hackthenorth/badge-hardware/README.md

# badge-hardware
Physical Hardware Designs for the 2026 Hacker Badge Project

IBOM Link: https://hackathon.github.io/badge-hardware/badge-ibom.html
