hackthenorth/badge-hardware/badge.kicad_pcb

## KiCad design badge.kicad_pcb (2026-10-14)

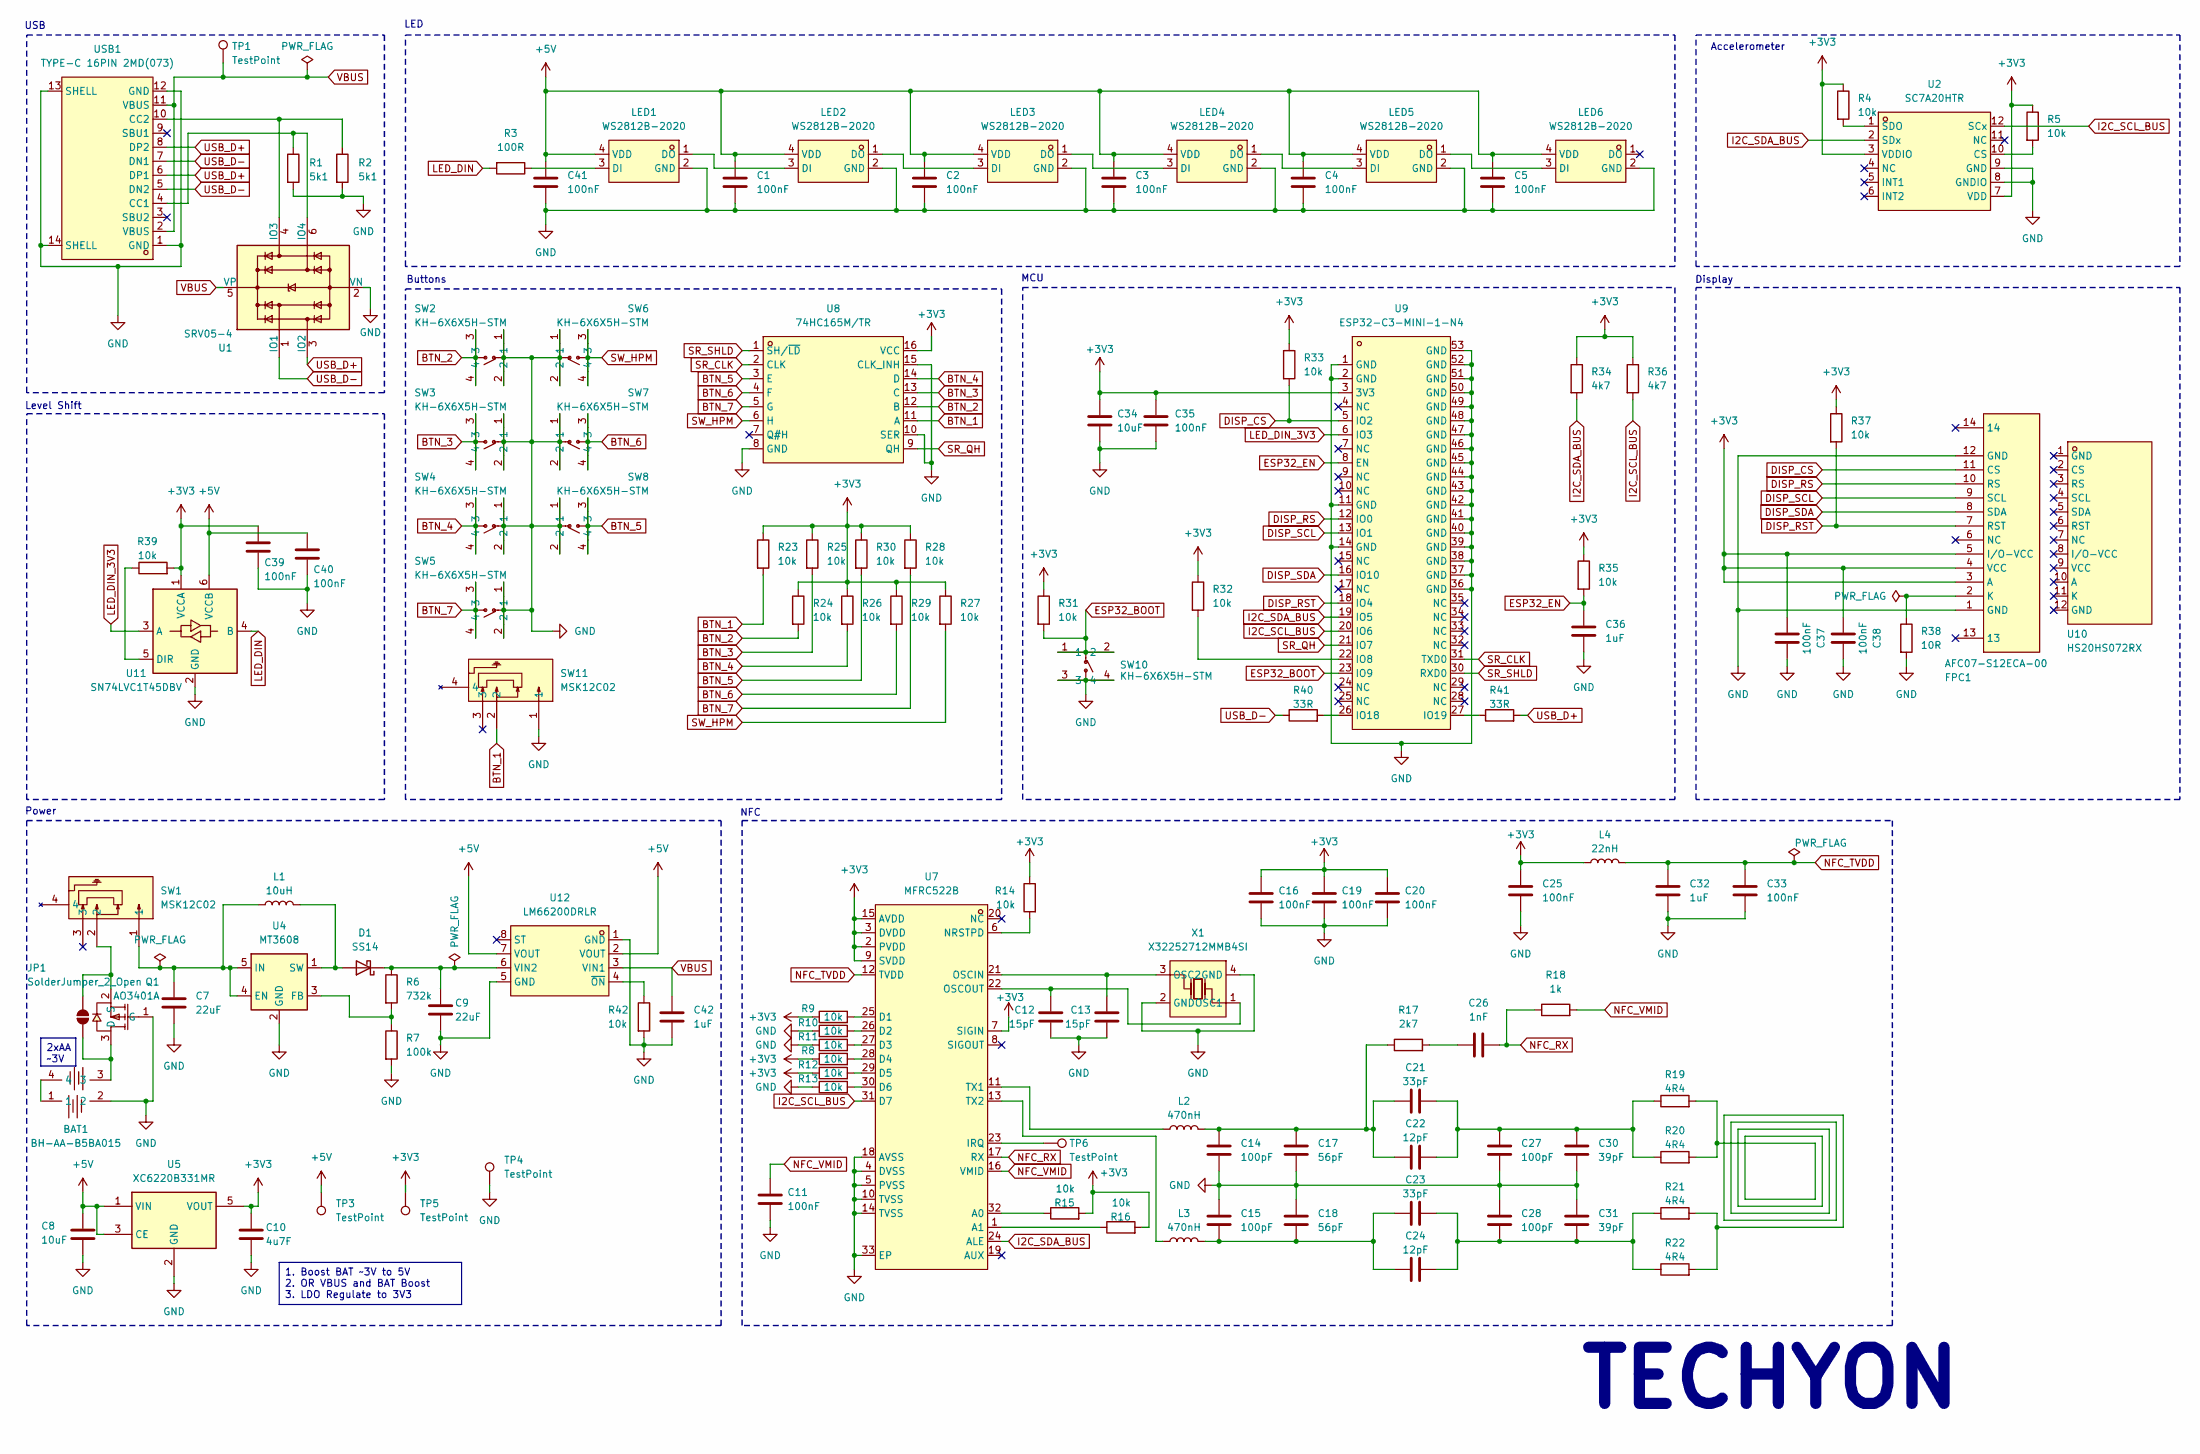
[picture p1: schematic badge.kicad_sch, Hacker Badge]

Parts:
BAT1: BH-AA-B5BA015; BAT-SMD_BH-AA-B5BA015; LCSC Part C5290182
C1, C2, C3, C4, C5, C11, C16, C19, C20, C25, C33, C41: 100nF; C_0805_2012Metric
C7, C9: 22uF; C_0805_2012Metric; LCSC Part C45783
C8, C34: 10uF; C_0805_2012Metric; LCSC Part C440198
C10: 4u7F; C_0805_2012Metric; LCSC Part C1779
C12, C13: 15pF; C_0805_2012Metric
C14, C15, C27, C28: 100pF; C_0805_2012Metric
C17, C18: 56pF; C_0805_2012Metric
C21, C23: 33pF; C_0805_2012Metric
C22, C24: 12pF; C_0805_2012Metric
C26: 1nF; C_0805_2012Metric
C30, C31: 39pF; C_0805_2012Metric
C32, C42: 1uF; C_0805_2012Metric
C35, C37, C38, C39, C40: 100nF; C_0805_2012Metric; LCSC Part C49678
C36: 1uF; C_0805_2012Metric; LCSC Part C28323
D1: SS14; D_SMA; LCSC Part C2480
FPC1: AFC07-S12ECA-00; FPC-SMD_12P-P0.50_AFC07-S12ECA-00; LCSC Part C262585
JP1: SolderJumper_2_Open; SolderJumper-2_P1.3mm_Open_Pad1.0x1.5mm
L1: 10uH; L_0805_2012Metric; LCSC Part C440198
L2, L3: 470nH; L_0805_2012Metric
L4: 22nH; L_0805_2012Metric
LED1, LED2, LED3, LED4, LED5, LED6: WS2812B-2020; LED-SMD_4P-L2.0-W2.0-TL_WS2812B-2020; LCSC Part C965555
Q1: AO3401A; SOT-23_L2.9-W1.3-P1.90-LS2.4-BR; MPN AO3401A; LCSC Part C15127
R1, R2: 5k1; R_0805_2012Metric; LCSC Part C27834
R3: 100R; R_0805_2012Metric
R4, R5, R8, R9, R10, R11, R12, R13, R14, R15, R16, R23, R24, R25, R26, R27, R28, R29, R30, R32, R33, R42: 10k; R_0805_2012Metric
R6: 732k; R_0805_2012Metric; LCSC Part C2684593
R7: 100k; R_0805_2012Metric; LCSC Part C149504
R17: 2k7; R_0805_2012Metric
R18: 1k; R_0805_2012Metric
R19, R20, R21, R22: 4R4; R_0805_2012Metric
R31, R35, R37, R39: 10k; R_0805_2012Metric; LCSC Part C17414
R34, R36: 4k7; R_0805_2012Metric
R38: 10R; R_0805_2012Metric; LCSC Part C17415
R40, R41: 33R; R_0805_2012Metric
SW1, SW11: MSK12C02; SW-TH_MSK12C02; LCSC Part C431540
SW2, SW3, SW4, SW5, SW6, SW7, SW8, SW10: KH-6X6X5H-STM; SW-SMD_4P-L6.0-W6.0-P4.50-LS9.0_H5.0; LCSC Part C2837531
TP1, TP3, TP4, TP5, TP6: TestPoint; TestPoint_Pad_D1.5mm
U1: SRV05-4; SOT-23-6; LCSC Part C7420376
U2: SC7A20HTR; LGA-12_L2.0-W2.0-P0.50-TL; LCSC Part C19274408
U4: MT3608; SOT-23-6; LCSC Part C84817
U5: XC6220B331MR; SOT-23-5; LCSC Part C22466451
U7: MFRC522B; VQFN-32_L5.0-W5.0-P0.50-BL-EP3.3; LCSC Part C41361613
U8: 74HC165M/TR; SOP-16_L10.0-W3.9-P1.27-LS6.0-BL; LCSC Part C507184
U9: ESP32-C3-MINI-1-N4; WIFIM-SMD_ESP32-C3-MINI-1; LCSC Part C2838502
U10: HS20HS072RX; OLED-SMD_HS20HS072RX; LCSC Part C5329582
U11: SN74LVC1T45DBV; SOT-23-6; LCSC Part C7843
U12: LM66200DRLR; SOT-583-8_L2.1-W1.2-P0.50-LS1.6-BL; LCSC Part C3235556
USB1: TYPE-C 16PIN 2MD(073); USB-C-SMD_TYPE-C-6PIN-2MD-073; LCSC Part C2765186
X1: X32252712MMB4SI; CRYSTAL-SMD_4P-L3.2-W2.5-BL-1; LCSC Part C29975

Connections:
+3V3: C10.2, C16.1, C19.1, C20.1, C25.1, C34.1, C35.1, C37.2, C38.2, C39.1, FPC1.3 (A), FPC1.4 (VCC), FPC1.5 (I/O-VCC), L4.1, R4.1, R5.1, R8.1, R9.1, R12.1, R14.1, R15.2, R16.2, R23.1, R24.1, R25.1, R26.1, R27.1, R28.1, R29.1, R30.1, R31.1, R32.1, R33.1, R34.1, R35.1, R36.1, R37.1, R39.2, TP5.1, U2.3 (VDDIO), U2.7 (VDD), U5.5 (VOUT), U7.2 (PVDD), U7.3 (DVDD), U7.7 (SIGIN), U7.9 (SVDD), U7.15 (AVDD), U8.16 (VCC), U9.3 (3V3), U11.1 (VCCA)
+5V: C1.1, C2.1, C3.1, C4.1, C5.1, C8.2, C40.1, C41.1, LED1.4 (VDD), LED2.4 (VDD), LED3.4 (VDD), LED4.4 (VDD), LED5.4 (VDD), LED6.4 (VDD), TP3.1, U5.1 (VIN), U5.3 (CE), U11.6 (VCCB), U12.2 (VOUT), U12.7 (VOUT)
BTN_1: R23.2, SW11.2, U8.11 (A)
BTN_2: R24.2, SW2.3, SW2.4, U8.12 (B)
BTN_3: R25.2, SW3.3, SW3.4, U8.13 (C)
BTN_4: R26.2, SW4.3, SW4.4, U8.14 (D)
BTN_5: R30.2, SW8.3, SW8.4, U8.3 (E)
BTN_6: R29.2, SW7.3, SW7.4, U8.4 (F)
BTN_7: R28.2, SW5.3, SW5.4, U8.5 (G)
DISP_CS: FPC1.11 (CS), R33.2, U9.5 (IO2)
DISP_RS: FPC1.10 (RS), U9.12 (IO0)
DISP_RST: FPC1.7 (RST), R37.2, U9.18 (IO4)
DISP_SCL: FPC1.9 (SCL), U9.13 (IO1)
DISP_SDA: FPC1.8 (SDA), U9.16 (IO10)
ESP32_BOOT: R31.2, SW10.1, SW10.2, U9.23 (IO9)
ESP32_EN: C36.1, R35.2, U9.8 (EN)
GND: BAT1.2, C1.2, C2.2, C3.2, C4.2, C5.2, C7.2, C8.1, C9.2, C10.1, C11.2, C12.2, C13.2, C14.2, C15.1, C16.2, C17.2, C18.1, C19.2, C20.2, C25.2, C27.2, C28.1, C30.2, C31.1, C32.2, C33.2, C34.2, C35.2, C36.2, C37.1, C38.1, C39.2, C40.2, C41.2, C42.2, FPC1.1 (GND), FPC1.12 (GND), LED1.2 (GND), LED2.2 (GND), LED3.2 (GND), LED4.2 (GND), LED5.2 (GND), LED6.2 (GND), Q1.1 (G), R1.2, R2.2, R7.2, R10.1, R11.1, R13.1, R38.2, R42.2, SW2.1, SW2.2, SW3.1, SW3.2, SW4.1, SW4.2, SW5.1, SW5.2, SW6.1, SW6.2, SW7.1, SW7.2, SW8.1, SW8.2, SW10.3, SW10.4, SW11.1, TP4.1, U1.2 (VN), U2.8 (GNDIO), U2.9 (GND), U4.2 (GND), U5.2 (GND), U7.4 (DVSS), U7.5 (PVSS), U7.10 (TVSS), U7.14 (TVSS), U7.18 (AVSS), U7.33 (EP), U8.8 (GND), U8.10 (SER), U8.15 (CLK_INH), U9.1 (GND), U9.2 (GND), U9.11 (GND), U9.14 (GND), U9.36 (GND), U9.37 (GND), U9.38 (GND), U9.39 (GND), U9.40 (GND), U9.41 (GND), U9.42 (GND), U9.43 (GND), U9.44 (GND), U9.45 (GND), U9.46 (GND), U9.47 (GND), U9.48 (GND), U9.49 (GND), U9.50 (GND), U9.51 (GND), U9.52 (GND), U9.53 (GND), U11.2 (GND), U12.1 (GND), U12.5 (GND), USB1.1 (GND), USB1.12 (GND), USB1.13 (SHELL), USB1.14 (SHELL), X1.2 (GND), X1.4 (GND)
I2C_SCL_BUS: R36.2, U2.12 (SCx), U7.31 (D7), U9.20 (IO6)
I2C_SDA_BUS: R34.2, U2.2 (SDx), U7.24 (ALE), U9.19 (IO5)
LED_DIN: R3.2, U11.4 (B)
LED_DIN_3V3: U9.6 (IO3), U11.3 (A)
NFC_RX: C26.2, R18.1, U7.17 (RX)
NFC_TVDD: C32.1, C33.1, L4.2, U7.12 (TVDD)
NFC_VMID: C11.1, R18.2, U7.16 (VMID)
unnamed: BAT1.1, BAT1.4
unnamed: C14.1, C17.1, C21.1, C22.1, L2.2, R17.1
unnamed: C15.2, C18.2, C23.1, C24.1, L3.2
unnamed: C21.2, C22.2, C27.1, C30.1, R19.1, R20.1
unnamed: C23.2, C24.2, C28.2, C31.2, R21.1, R22.1
unnamed: C26.1, R17.2
unnamed: D1.2 (A), L1.2, U4.1 (SW)
unnamed: C9.1, D1.1 (K), R6.1, U12.6 (VIN2)
unnamed: FPC1.2 (K), R38.1
unnamed: BAT1.3, JP1.1 (A), Q1.3 (D)
unnamed: JP1.2 (B), Q1.2 (S), SW1.2
unnamed: LED1.3 (DI), R3.1
unnamed: LED1.1 (DO), LED2.3 (DI)
unnamed: LED2.1 (DO), LED3.3 (DI)
unnamed: LED3.1 (DO), LED4.3 (DI)
unnamed: LED4.1 (DO), LED5.3 (DI)
unnamed: LED5.1 (DO), LED6.3 (DI)
unnamed: R19.2, R20.2, R21.2, R22.2
unnamed: R2.1, U1.4 (IO3), USB1.10 (CC2)
unnamed: R1.1, U1.6 (IO4), USB1.4 (CC1)
unnamed: R5.2, U2.10 (CS)
unnamed: R4.2, U2.1 (SDO)
unnamed: C7.1, L1.1, SW1.1, U4.4 (EN), U4.5 (IN)
unnamed: R6.2, R7.1, U4.3 (FB)
unnamed: R15.1, U7.32 (A0)
unnamed: R16.1, U7.1 (A1)
unnamed: R9.2, U7.25 (D1)
unnamed: R10.2, U7.26 (D2)
unnamed: R11.2, U7.27 (D3)
unnamed: R8.2, U7.28 (D4)
unnamed: R12.2, U7.29 (D5)
unnamed: R13.2, U7.30 (D6)
unnamed: TP6.1, U7.23 (IRQ)
unnamed: R14.2, U7.6 (NRSTPD)
unnamed: C13.1, U7.21 (OSCIN), X1.3 (OSC2)
unnamed: C12.1, U7.22 (OSCOUT), X1.1 (OSC1)
unnamed: L2.1, U7.11 (TX1)
unnamed: L3.1, U7.13 (TX2)
unnamed: R32.2, U9.22 (IO8)
unnamed: R40.2, U9.26 (IO18)
unnamed: R41.1, U9.27 (IO19)
unnamed: R39.1, U11.5 (DIR)
unnamed: R42.1, U12.4 (~ON)
SR_CLK: U8.2 (CLK), U9.31 (TXD0)
SR_QH: U8.9 (QH), U9.21 (IO7)
SR_SHLD: U8.1 (SH/~LD), U9.30 (RXD0)
SW_HPM: R27.2, SW6.3, SW6.4, U8.6 (H)
USB_D+: R41.2, U1.3 (IO2), USB1.6 (DP1), USB1.8 (DP2)
USB_D-: R40.1, U1.1 (IO1), USB1.5 (DN2), USB1.7 (DN1)
VBUS: C42.1, TP1.1, U1.5 (VP), U12.3 (VIN1), USB1.2 (VBUS), USB1.11 (VBUS)

Notes on the sheet:
USB
Display
NFC
TECHYON
LED
Power
Buttons
Accelerometer
Level Shift
MCU
2xAA ~3V
1. Boost BAT ~3V to 5V 2. OR VBUS and BAT Boost 3. LDO Regulate to 3V3

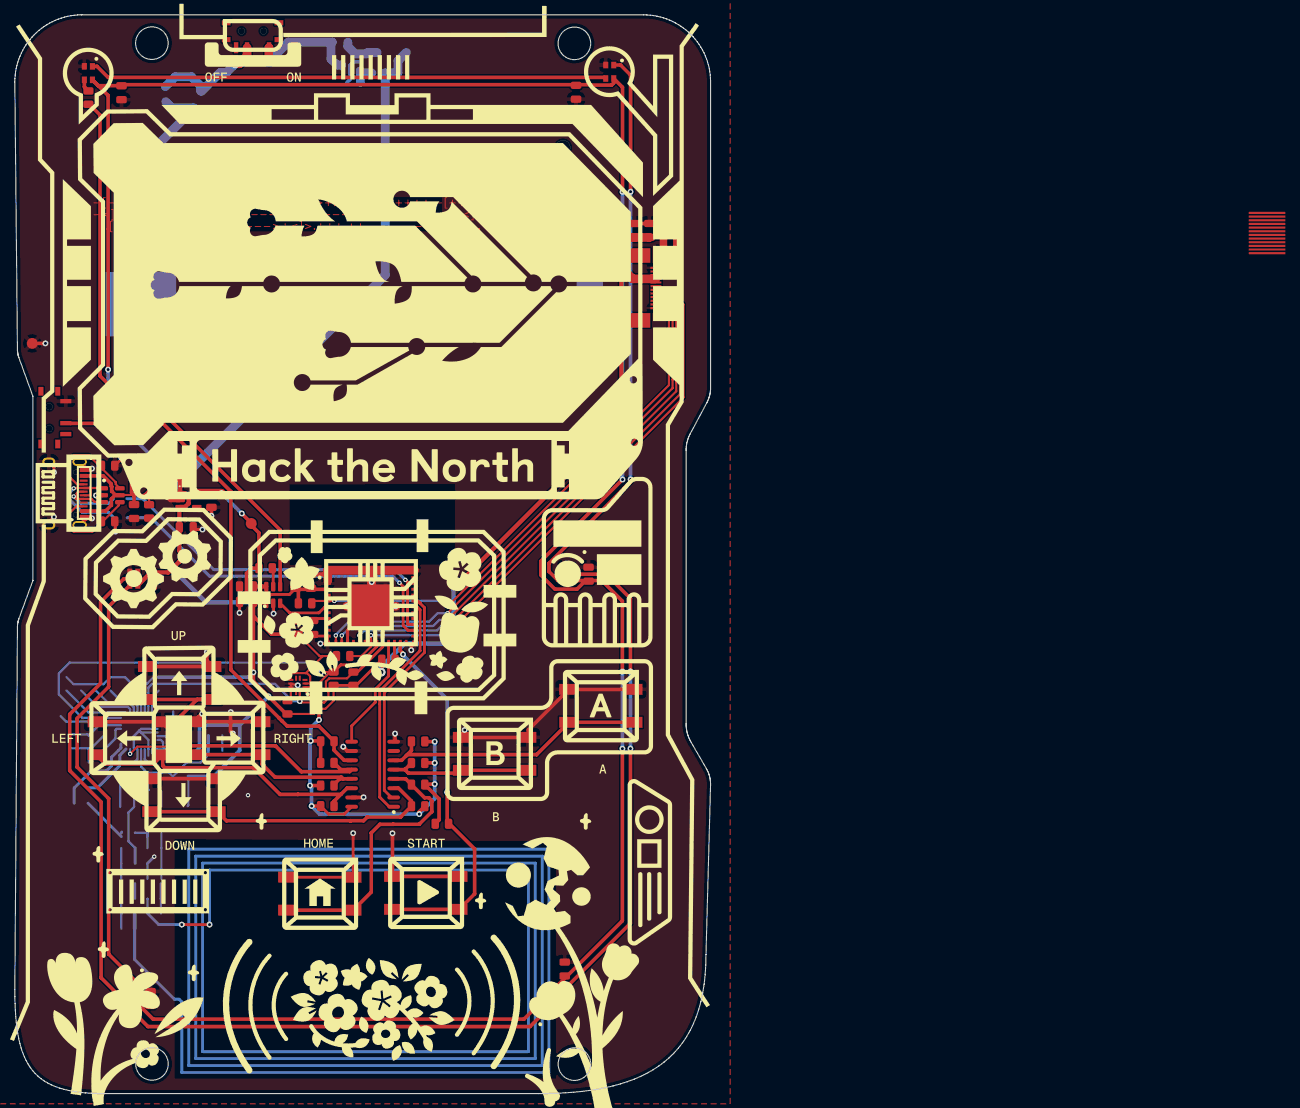
[picture p2: board badge.kicad_pcb from above]

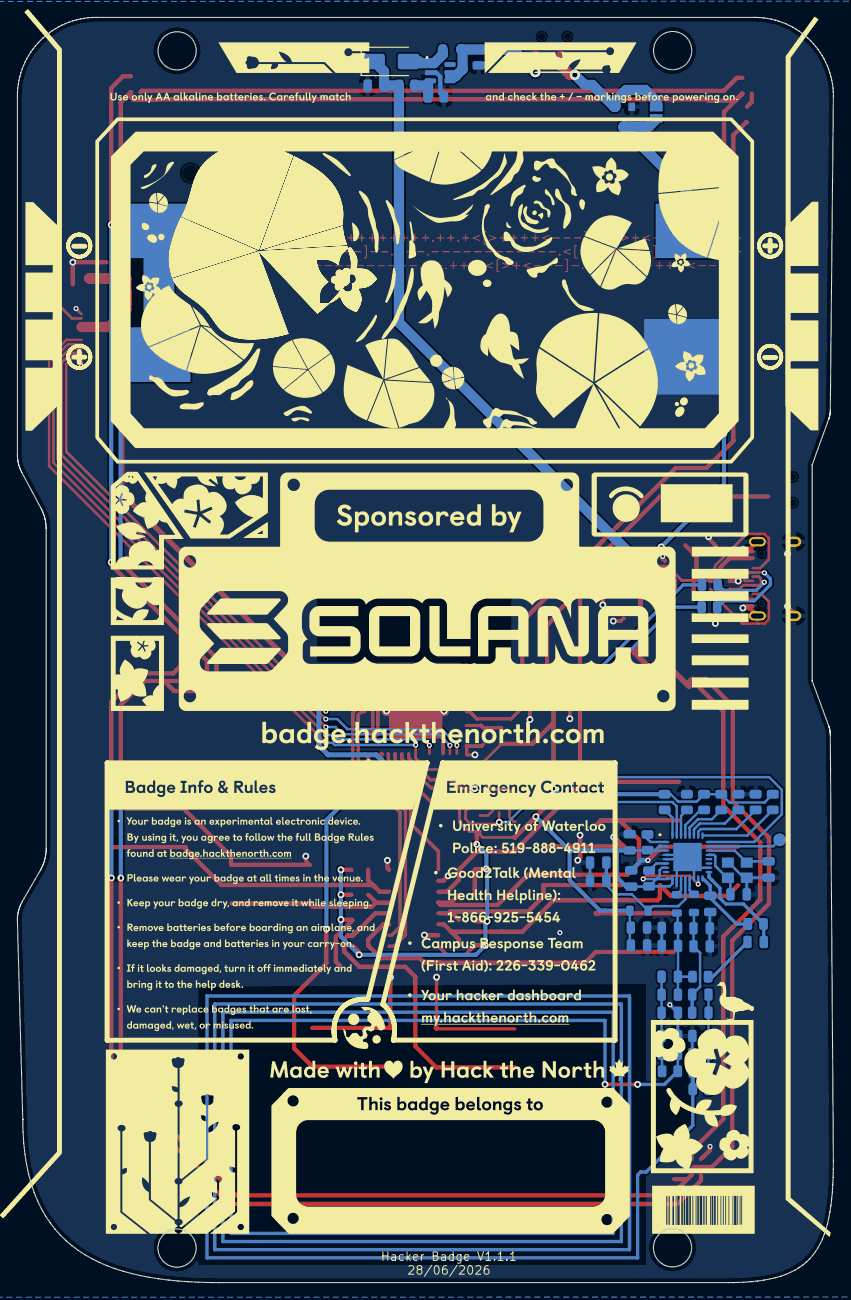
[picture p3: board badge.kicad_pcb from below]

Board: 2 copper layers, 95.0 x 147.3 mm, 124 parts (55 on the bottom side), 74 nets.
